Agilack/pmod-flash/prj-kicad/3d-models/README.md

About 3D Models
---------------

This 3D models have been insert for visual preview only. Precise size of
components are not guaranteed.

 * Connector 61301221021 : This model has been made using a 3D step
   converted to WRL with FreeCAD.

 * WSON8 : This model comes from [UltraLibrarian](https://ultralibrarian.com)
   website. The "X" coordinate need a special scale factor (i don't know why)
