Agilack/pmod-flash/(commit log)

2022-09-20 = ADD: Initial schematics and routing
    [pmod-flash.kicad_pcb, pmod-flash.kicad_sch]
2022-09-22 = ADD: Modify circuit to support a second flash chip
    [pmod-flash.kicad_pcb, pmod-flash.kicad_sch]
2022-09-24 = ADD: Create production files for rev1 and 3D models for a better preview
    [pmod-flash-B_Cu.gbr, pmod-flash-B_Mask.gbr, pmod-flash-B_Paste.gbr, pmod-flash-B_Silkscreen.gbr, pmod-flash-Edge_Cuts.gbr, pmod-flash-F_Cu.gbr, pmod-flash-F_Mask.gbr, pmod-flash-F_Paste.gbr]
